UnforeseenOcean/Loki/Loki-01.png

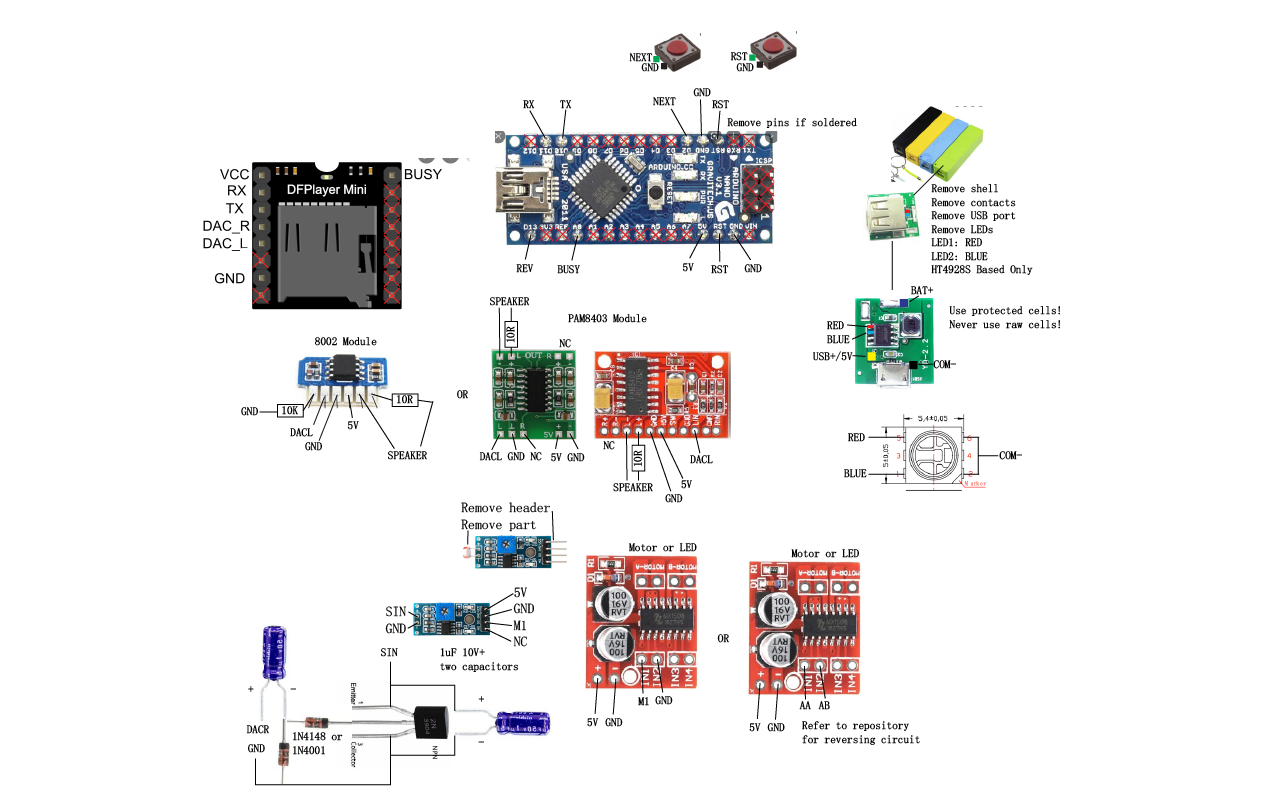
Loki-01.png
