UnforeseenOcean/Loki/LokiSchematic.png

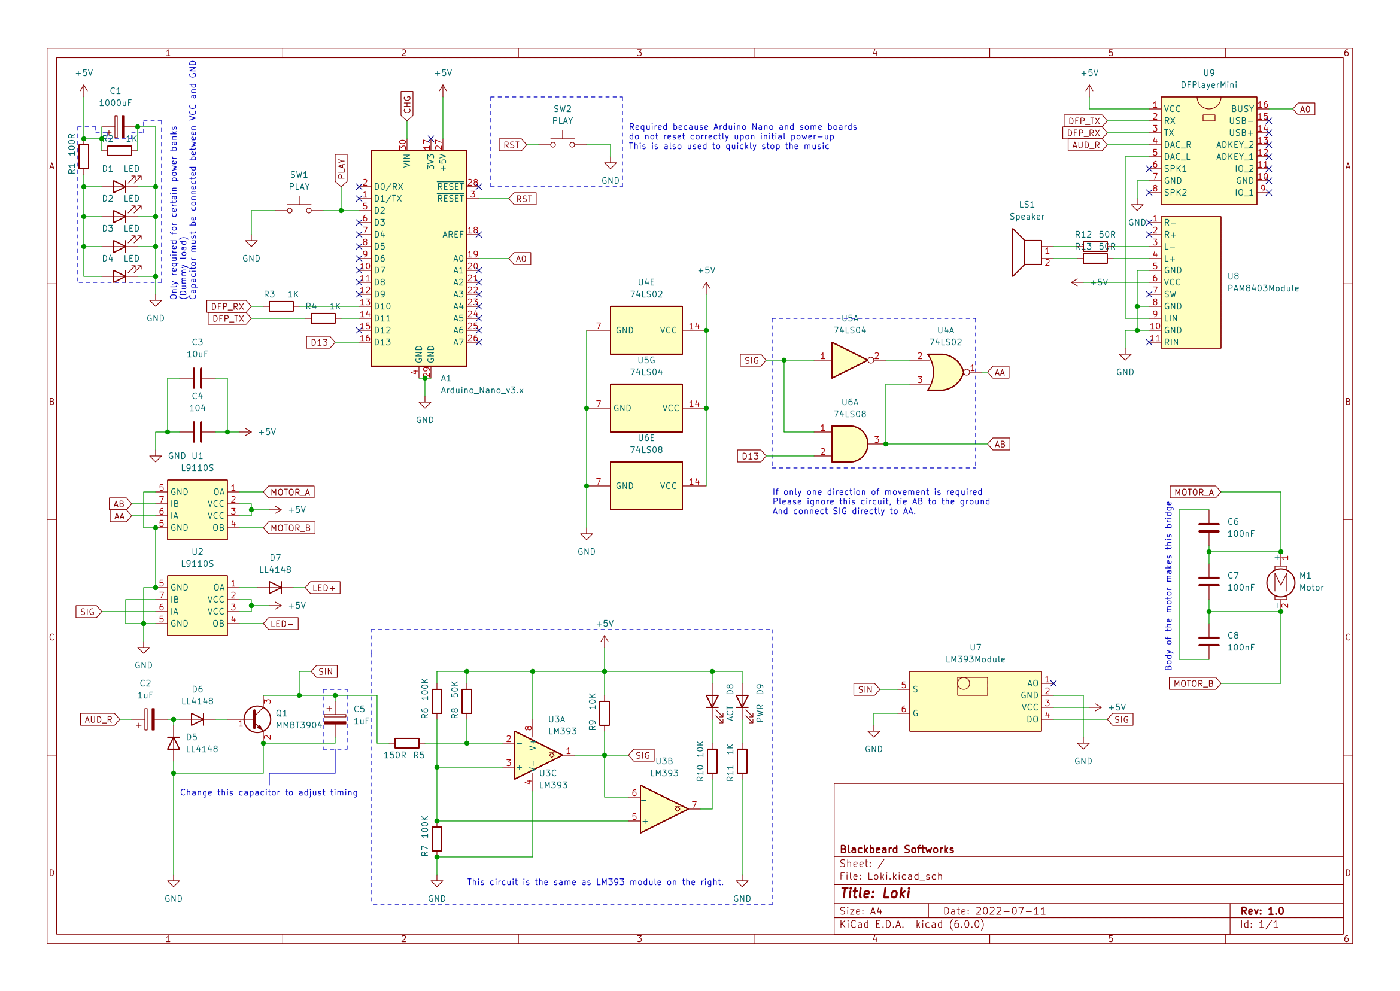
LokiSchematic.png
