UnforeseenOcean/Loki/(commit log)

2022-07-12 Add schematic
2022-07-12 Added description: How reversing circuit works
2022-09-29 Code now ignores HW status
    Hence, the A0 pin is unused. All the bad practice codes were removed and partially rewritten.
    If you already built Loki, this code should still work. This also fixes the unresponsive button issue on modules using `MH2924K-24SS` MP3/WAV player ASIC.
    [Loki.ino]
